vha3/Monarch-Board/Images/IMG_7050.JPG

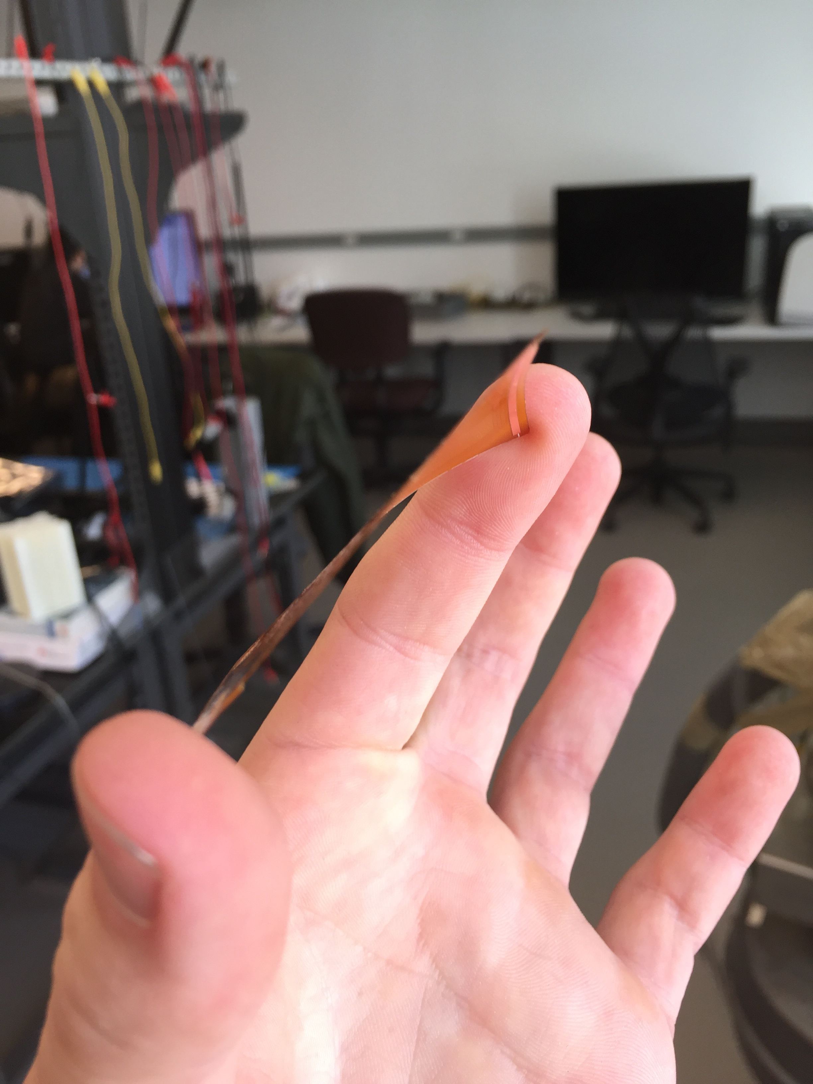
Images/IMG_7050.JPG
