vha3/Monarch-Board/Images/IMG_7051.JPG

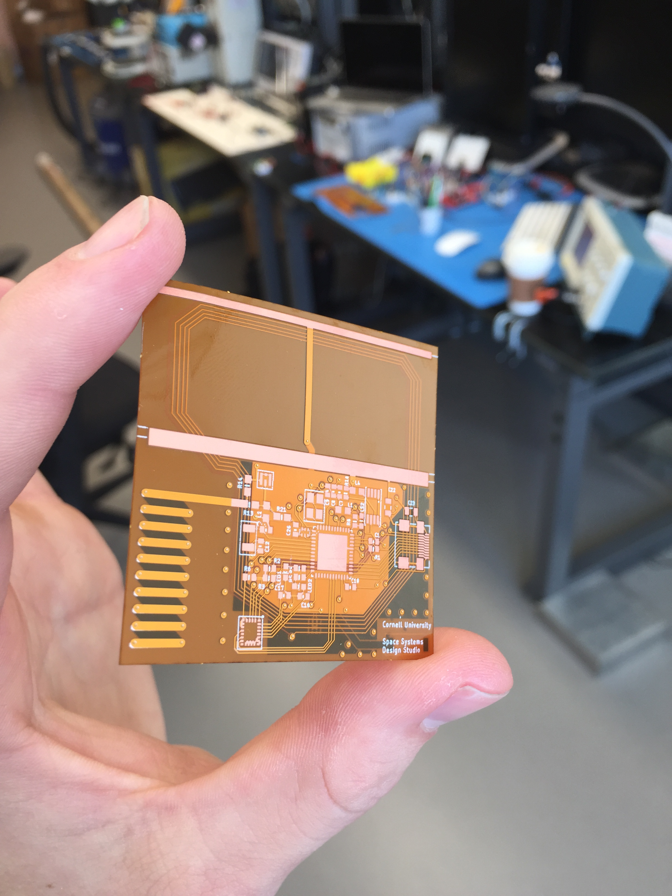
Images/IMG_7051.JPG
