vha3/Monarch-Board/BOM/BOM.xlsx

BOM:
Assembly P/N:
Customer Name: V. Hunter Adams (Cornell University)
Qty | Value | Do Not Install | Device | Package | Parts | Description | Vendor | Vendor P/N | Manufacturer P/N | Manufacturer | URL
11 | 0.1 uF |  | CAP0402-CAP | 0402-CAP | C1, C2, C3, C4, C5, C7, C9, C14, C15, C17, C18 | Capacitor | Digikey | 311-1676-2-ND | CC0402JRX7R7BB104 | Yageo | https://www.digikey.com/product-detail/en/yageo/CC0402JRX7R7BB104/311-1676-2-ND/5195085
1 | 1 uF |  | CAP0402-CAP | 0402-CAP | C10 | Capacitor | Digikey | 445-9082-2-ND | C1005X6S1C105M050BC | TDK Corporation | https://www.digikey.com/product-detail/en/tdk-corporation/C1005X6S1C105M050BC/445-9082-2-ND/3661566
1 | 10 nF |  | CAP0402-CAP | 0402-CAP | C16 | Capacitor | Digikey | 478-3664-2-ND | 0402YC103JAT2A | AVX Corporation | https://www.digikey.com/product-detail/en/avx-corporation/0402YC103JAT2A/478-3664-2-ND/1116188
1 | 10 uF |  | CAP0402-CAP | 0402-CAP | C13 | Capacitor | Digikey | 490-10693-2-ND | GRM155R60G106ME44D | Murata | https://www.digikey.com/product-detail/en/murata-electronics-north-america/GRM155R60G106ME44D/490-10693-2-ND/4905101
1 | 100 pF |  | CAP0402-CAP | 0402-CAP | C26 | Capacitor | Digikey | 478-1089-2-ND | 04025C101KAT2A | AVX Corporation | https://www.digikey.com/product-detail/en/avx-corporation/04025C101KAT2A/478-1089-2-ND/563199
1 | 100 pF |  | CAP0603-CAP | 0603-CAP | C19 | Capacitor | Digikey | 490-1427-1-ND | GRM1885C1H101JA01D | Murata | https://www.digikey.com/product-detail/en/murata-electronics-north-america/GRM1885C1H101JA01D/490-1427-1-ND/587633
1 | 100 uF |  | CAP0805 | 805 | C20 | Capacitor | Digikey | 478-8358-1-ND | F950G107MPAAQ2 | AVX Corporation | https://www.digikey.com/product-detail/en/avx-corporation/F950G107MPAAQ2/478-8358-1-ND/4005658
1 | 100k |  | RESISTOR0402-RES | 0402-RES | R1 | Resistor | Digikey | P100KDCTR-ND | ERA-2AEB104X | Panasonic | https://www.digikey.com/product-detail/en/panasonic-electronic-components/ERA-2AEB104X/P100KDCTR-ND/1706053
5 | 10k |  | RESISTOR0402-RES | 0402-RES | R6, R7, R8, R9, R12 | Resistor | Digikey | P10KDECT-ND | ERA-2AED103X | Panasonic | https://www.digikey.com/product-detail/en/panasonic-electronic-components/ERA-2AED103X/P10KDECT-ND/1706304
2 | 12 pF |  | CAP0402-CAP | 0402-CAP | C11, C12 | Capacitor | Digikey | 490-5924-2-ND | GRM1555C1H120JA01D | Murata | https://www.digikey.com/product-detail/en/murata-electronics-north-america/GRM1555C1H120JA01D/490-5924-2-ND/3693831
3 | 180 |  | RESISTOR0402-RES | 0402-RES | R4, R5, R10 | Resistor | Digikey | P180DCCT-ND | ERA-2AEB181X | Panasonic | https://www.digikey.com/product-detail/en/panasonic-electronic-components/ERA-2AEB181X/P180DCCT-ND/1706165
1 | 1k |  | RESISTOR0402-RES | 0402-RES | R11 | Resistor | Digikey | P1.0KDECT-ND | ERA-2AED102X | Panasonic | https://www.digikey.com/product-detail/en/panasonic-electronic-components/ERA-2AED102X/P1.0KDECT-ND/1706280
2 | 22 uF |  | CAP0402-CAP | 0402-CAP | C6, C8 | Capacitor | Digikey | 1276-6834-2-ND | CL05A226MQ5QUNC | Samsung | https://www.digikey.com/product-detail/en/samsung-electro-mechanics/CL05A226MQ5QUNC/1276-6834-2-ND/5961318
3 | 3.3k |  | RESISTOR0402-RES | 0402-RES | R2, R3, R19 | Resistor | Digikey | P3.3KDCCT-ND | ERA-2AEB332X | Panasonic | https://www.digikey.com/product-detail/en/panasonic-electronic-components/ERA-2AEB332X/P3.3KDCCT-ND/1706195
1 | 330 |  | RESISTOR0402-RES | 0402-RES | R20 | Resistor | Digikey | P330DECT-ND | ERA-2AED331X | Panasonic | https://www.digikey.com/product-detail/en/panasonic-electronic-components/ERA-2AED331X/P330DECT-ND/1706268
2 | 47 uF |  | CAP0805 | 805 | C22, C23 | Capacitor | Digikey | 490-6469-2-ND | GRM21BR60G476ME15L | Murata | https://www.digikey.com/product-detail/en/murata-electronics-north-america/GRM21BR60G476ME15L/490-6469-2-ND/2546873
1 | 10uH |  | ASPI-0315FS | ASPI-0315FS | L4 | Inductor | Digikey | 535-10735-2-ND | ASPI-0315FS-100M-T2 | Abracon LLC | https://www.digikey.in/product-detail/en/abracon-llc/ASPI-0315FS-100M-T2/535-10735-2-ND/2619300
1 | 2.2nH |  | INDUCTOR0603 | 603 | L3 | Inductor | Digikey | 712-1427-1-ND | L-14C2N2SV4T | Johanson Technology | https://www.digikey.com/scripts/DkSearch/dksus.dll?Detail&itemSeq=251947178&uq=636552498736187867
1 | 6.8 uH |  | INDUCTOR0603 | 603 | L1 | Inductor | Digikey | 445-1023-2-ND | MLF1608E6R8KTA00 | TDK Corporation | https://www.digikey.com/product-detail/en/tdk-corporation/MLF1608E6R8KTA00/445-1023-2-ND/504192
2 | GREEN |  | LED0603 | LED-0603 | LED3,LED2 | LED | Digikey | 475-2709-1-ND | LG L29K-G2J1-24-Z | OSRAM Opto | https://www.digikey.com/products/en?keywords=475-2709-1-ND
1 | CC1310 |  | CC1310 | CC1310 | MICROCONTROLLER | CC1310 RGZ48 package | Digikey | 296-44348-1-ND | CC1310F128RGZR | Texas Instruments | https://www.digikey.com/product-detail/en/texas-instruments/CC1310F128RGZR/296-44348-1-ND/6110621
1 | FC-135 |  | FC-135 | FC-135 | 32.768 | FC-135 32.768KA-AG0 | Digikey | SER4084CT-ND | FC-135 32.7680KA-AC0 | Epson | https://www.digikey.com/product-detail/en/epson/FC-135-32.7680KA-AC0/SER4084CT-ND/6132704
1 | HDMID |  | HDMID | HDMID | U$1 | HDMI-D Female | Digikey | WM11254CT-ND | 467650301 | Molex | https://www.digikey.com/product-detail/en/molex-llc/0467650301/WM11254CT-ND/5287246
1 | JOHANSON_BALUN |  | JOHANSON_BALUN | JOHANSON_BALUN | BALUN | 915 MHz Balun | Digikey | 712-1621-1-ND | 0850BM14E0016T | Johanson Technology | https://www.digikey.com/product-detail/en/johanson-technology-inc/0850BM14E0016T/712-1621-1-ND/6187665
1 | JOHANSON_GPS_CHIP |  | JOHANSON_GPS_CHIP | JOHANSON_GPS_CHIP | U$5 | GPS Chip Antenna | Digikey | 712-1003-1-ND | 1575AT43A0040E | Johanson Technology | https://www.digikey.com/product-detail/en/johanson-technology-inc/1575AT43A0040E/712-1003-1-ND/1560832
1 | L6920 |  | L6920 | L6920 | U$8 | Boost Converter | Digikey | 497-3368-1-ND | L6920DTR | STMicroelectronics | https://www.digikey.com/product-detail/en/stmicroelectronics/L6920DTR/497-3368-1-ND/668269
2 | LIGHTSENSORALS |  | LIGHTSENSORALS | ALS-PT19 | LS1, LS2 | Ambient Light Sensor | Digikey | 1080-1244-1-ND | ALS-PT19-315C/L177/TR8 | Everlight Electronics | https://www.digikey.com/products/en?keywords=1080-1244-1-ND
1 | LSM9DS1 |  | LSM9DS1 | LGA24-8X4 | IMU | LSM9DS1 3D accelerometer, gyroscope & magnetometer | Digikey | 497-14946-1-ND | LSM9DS1TR | STMicroelectronics | https://www.digikey.com/products/en?keywords=497-14946-1-ND
1 | LV8417CS |  | LV8417CS | LV8417CS | U$2 | H-Bridge motor driver | Digikey | LV8417CS-TE-L-HOSCT-ND | LV8417CS-TE-L-H | ON Semiconductor | https://www.digikey.com/products/en?keywords=LV8417CS-TE-L-HOSCT-ND
1 | PANASONIC_RECTIFIER |  | PANASONIC_RECTIFIER | PANASONIC_RECTIFIER | U$4 | Full bridge rectifier | Digikey | DA4X106U0RCT-ND | DA4X106U0R | Panasonic | https://www.digikey.com/product-detail/en/panasonic-electronic-components/DA4X106U0R/DA4X106U0RCT-ND/2673416
1 | RED |  | LED0603 | LED-0603 | LED1 | LED | Digikey | 475-2506-1-ND | LS L29K-G1J2-1-Z | OSRAM Opto | https://www.digikey.com/product-detail/en/osram-opto-semiconductors-inc/LS-L29K-G1J2-1-Z/475-2506-1-ND/1802633
1 | TSX-3225 |  | TSX-3225 | TSX-3225 | TSX-3225 | 24 MHz Oscillator | Digikey | SER4185CT-ND | TSX-3225 24.0000MF20G-AC0 | Epson | https://www.digikey.com/product-detail/en/epson/TSX-3225-24.0000MF20G-AC0/SER4185CT-ND/6614145
1 | VENUS838FLPX |  | VENUS838FLPX | VENUS838FLPX | GPS | Venus838FLPx-L | I will mail these to you | I will mail these to you | I will mail these to you | I will mail these to you | I will mail these to you
2 | ALTA_CELL | DNI | ALTA_CELL | ALTA_CELL | FRONT_PANEL, REAR_PANEL | Solar Cells |  | N/A | N/A | N/A | N/A
