vha3/Monarch-Board/CPL/CPL.xlsx

Top
Name | X-Coord | Y-Coord | Rotation | Value | Package
32.768 | 16.41 | 16.05 | 90 | FC-135 | FC-135
BALUN | 25.37 | 17.48 | 90 | JOHANSON_BALUN | JOHANSON_BALUN
C1 | 37.79 | 17.14 | 0 | 100nF | 0402-CAP
C7 | 31.13 | 23.81 | 90 | 100nF | 0402-CAP
C8 | 30.04 | 23.8 | 90 | 22uF | 0402-CAP
C9 | 28.97 | 23.8 | 270 | 100nF | 0402-CAP
C10 | 33.68 | 10.29 | 0 | 1uF | 0402-CAP
C11 | 19.05 | 17.32 | 0 | 12pF | 0402-CAP
C12 | 18.31 | 15.1 | 270 | 12pF | 0402-CAP
C16 | 25.56 | 8.71 | 180 | 10nF | 0402-CAP
C17 | 22.42 | 8.74 | 0 | 0.1uF | 0402-CAP
C19 | 15.85 | 23.03 | 270 | 100pF | 0603-CAP
C22 | 40.41 | 22.51 | 270 | 47uF | 805
C23 | 44.83 | 22.94 | 270 | 47uF | 805
C26 | 23.79 | 17.74 | 270 | 100pF | 0402-CAP
IMU | 17.4 | 3.83 | 270 | LSM9DS1 | LGA24-8X4
L1 | 31.86 | 21.19 | 180 | 6.8uH | 603
L4 | 33.77 | 24.42 | 180 | 10uH | ASPI-0315FS
LED1 | 22.48 | 11.86 | 180 | RED | LED-0603
LED2 | 24.74 | 9.99 | 270 | GREEN | LED-0603
LS2 | 35.12 | 19.94 | 270 | LIGHTSENSORALS | ALS-PT19
MICROCONTROLLER | 30.26 | 15.01 | 0 | CC1310 | CC1310
R1 | 37.81 | 16.04 | 180 | 100k | 0402-RES
R2 | 19.9 | 12.21 | 180 | 3.3k | 0402-RES
R3 | 19.89 | 10.91 | 180 | 3.3k | 0402-RES
R4 | 24.75 | 12.48 | 0 | 180 | 0402-RES
R5 | 24.78 | 11.27 | 0 | 180 | 0402-RES
R6 | 16.82 | 10.9 | 180 | 10k | 0402-RES
R8 | 33.98 | 19.94 | 90 | 10k | 0402-RES
REAR_PANEL | 24.96 | 39.06 | 180 | ALTA_CELL | ALTA_CELL
TSX3225 | 26.67 | 20.78 | 0 | TSX-3225 | TSX-3225
U$6 | 14.1 | 20.5 | 270 | PCB_ANTENNA | PCB_ANTENNA
U$8 | 37.46 | 22.31 | 180 | L6920 | L6920
U$9 | 45.87 | 17.05 | 90 | HDMID | HDMID
Bottom
C2 | 36.67 | 11.72 | 180 | 100nF | 0402-CAP
C3 | 36.68 | 10.64 | 180 | 100nF | 0402-CAP
C4 | 36.69 | 9.56 | 180 | 100nF | 0402-CAP
C5 | 36.69 | 8.49 | 180 | 100nF | 0402-CAP
C6 | 33.64 | 11.73 | 0 | 22uF | 0402-CAP
C13 | 33.63 | 10.64 | 0 | 10uF | 0402-CAP
C14 | 33.62 | 9.57 | 0 | 0.1uF | 0402-CAP
C15 | 33.61 | 8.49 | 0 | 0.1uF | 0402-CAP
C18 | 22.19 | 23.35 | 180 | 0.1uF | 0402-CAP
C20 | 37.68 | 18.69 | 270 | 100uF | 805
FRONT_PANEL | 24.96 | 39.05 | 180 | ALTA_CELL | ALTA_CELL
GPS | 25.72 | 14.89 | 270 | VENUS838FLPX | VENUS838FLPX
L3 | 31.66 | 4.99 | 180 | 2.2nH | 603
LED3 | 26.49 | 25.22 | 90 | BLUE | LED-0603
LS1 | 33.82 | 14.54 | 90 | LIGHTSENSORALS | ALS-PT19
R7 | 32.47 | 14.66 | 270 | 10k | 0402-RES
R9 | 19.4 | 16.65 | 270 | 10k | 0402-RES
R10 | 26.6 | 22.8 | 180 | 180 | 0402-RES
R11 | 29.7 | 22.79 | 180 | 1k | 0402-RES
R12 | 22.19 | 22.22 | 0 | 10k | 0402-RES
R19 | 33.93 | 19.64 | 180 | 3.3k | 0402-RES
R20 | 34.82 | 23.84 | 90 | 331 | 0402-RES
U$2 | 32.77 | 23.11 | 0 | LV8417CS | LV8417CS
U$4 | 37.66 | 23.46 | 0 | PANASONIC_RECTIFIER | PANASONIC_RECTIFIER
U$5 | 44.98 | 2.24 | 0 | JOHANSON_GPS_CHIP | JOHANSON_GPS_CHIP
