vha3/Monarch-Board/Eagle/Sprite_CC1310_Development.brd

## EAGLE design Eagle/Sprite_CC1310_Development.brd (2018-06-07)

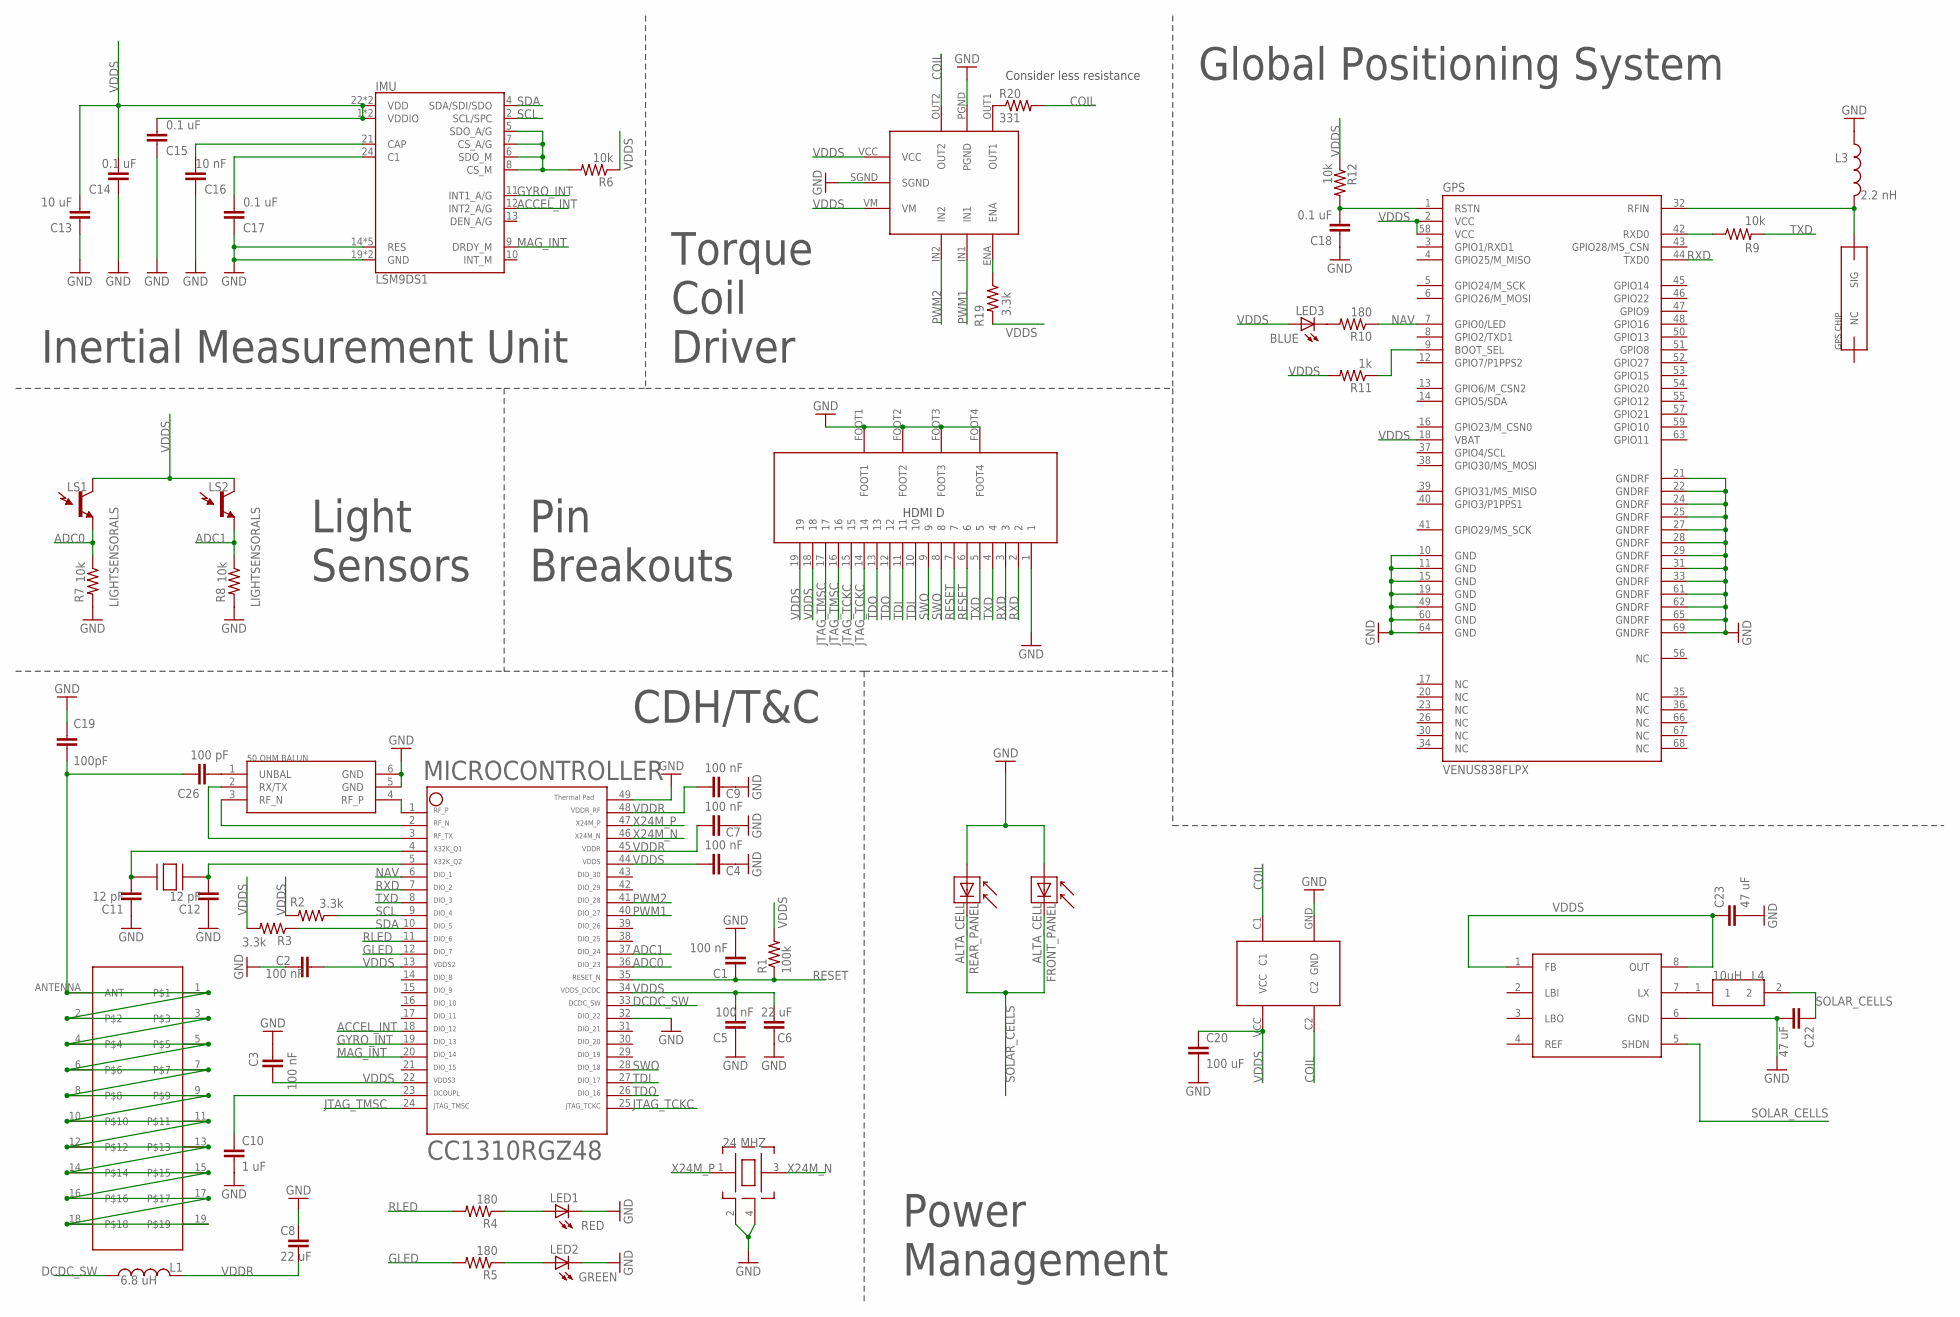
[picture p3: schematic Sprite_CC1310_Development.sch]

Parts:
32.768: FC-135
BALUN: JOHANSON_BALUN
C1, C2, C3, C4, C5, C7, C9: 100 nF; 0402-CAP
C6, C8: 22 uF; 0402-CAP
C10: 1 uF; 0402-CAP
C11, C12: 12 pF; 0402-CAP
C13: 10 uF; 0402-CAP
C14, C15, C17, C18: 0.1 uF; 0402-CAP
C16: 10 nF; 0402-CAP
C19: 100pF; 0603-CAP
C20: 100 uF; 0805
C22, C23: 47 uF; 0805
C26: 100 pF; 0402-CAP
FRONT_PANEL: ALTA_CELL
GPS: VENUS838FLPX
IMU: LSM9DS1; LGA24-8X4
L1: 6.8 uH; 0603
L3: 2.2 nH; 0603
L4: 10uH; ASPI-0315FS
LED1: RED; LED-0603
LED2: GREEN; LED-0603
LED3: BLUE; LED-0603
LS1, LS2: LIGHTSENSORALS; ALS-PT19
MICROCONTROLLER: CC1310
R1: 100k; 0402-RES
R2, R3, R19: 3.3k; 0402-RES
R4, R5, R10: 180; 0402-RES
R6, R7, R8, R9, R12: 10k; 0402-RES
R11: 1k; 0402-RES
R20: 331; 0402-RES
REAR_PANEL: ALTA_CELL
TSX3225: TSX-3225
U$2: LV8417CS
U$4: PANASONIC_RECTIFIER
U$5: JOHANSON_GPS_CHIP
U$6: PCB_ANTENNA
U$8: L6920
U$9: HDMID

Connections:
ACCEL_INT: IMU.12 (INT2_A/G), MICROCONTROLLER.18
ADC0: LS1.E (E1), MICROCONTROLLER.36, R7.1
ADC1: LS2.E (E1), MICROCONTROLLER.37, R8.1
ANTENNA: C19.2, C26.1, U$6.1, U$6.2, U$6.3, U$6.4, U$6.5, U$6.6, U$6.7, U$6.8, U$6.9, U$6.10, U$6.11, U$6.12, U$6.13, U$6.14, U$6.15, U$6.16, U$6.17, U$6.18, U$6.19, U$6.ANTENNA (ANT)
COIL: R20.2, U$2.OUT2, U$4.C1, U$4.C2
DCDC_SW: L1.1, MICROCONTROLLER.33
GLED: MICROCONTROLLER.12, R5.2
GND: BALUN.5 (GND), BALUN.6 (GND), C1.2, C2.2, C3.2, C4.2, C5.2, C6.2, C7.2, C8.2, C9.2, C10.2, C11.2, C12.2, C13.2, C14.2, C15.2, C16.2, C17.2, C18.2, C19.1, C20.2, C22.2, C23.2, FRONT_PANEL.-, GPS.10 (GND), GPS.11 (GND), GPS.15 (GND), GPS.19 (GND), GPS.21 (GNDRF), GPS.22 (GNDRF), GPS.24 (GNDRF), GPS.25 (GNDRF), GPS.27 (GNDRF), GPS.28 (GNDRF), GPS.29 (GNDRF), GPS.31 (GNDRF), GPS.33 (GNDRF), GPS.49 (GND), GPS.60 (GND), GPS.61 (GNDRF), GPS.62 (GNDRF), GPS.64 (GND), GPS.65 (GNDRF), GPS.69 (GNDRF), IMU.14 (RES), IMU.15 (RES), IMU.16 (RES), IMU.17 (RES), IMU.18 (RES), IMU.19 (GND), IMU.20 (GND), L3.1, LED1.C, LED2.C, MICROCONTROLLER.32, MICROCONTROLLER.49, R7.2, R8.2, REAR_PANEL.-, TSX3225.2, TSX3225.4, U$2.PGND, U$2.SGND, U$4.GND, U$8.6 (GND), U$9.1, U$9.FOOT1, U$9.FOOT2, U$9.FOOT3, U$9.FOOT4
GYRO_INT: IMU.11 (INT1_A/G), MICROCONTROLLER.19
JTAG_TCKC: MICROCONTROLLER.25, U$9.14, U$9.15
JTAG_TMSC: MICROCONTROLLER.24, U$9.16, U$9.17
MAG_INT: IMU.9 (DRDY_M), MICROCONTROLLER.20
unnamed: C10.1, MICROCONTROLLER.23
unnamed: 32.768.P2, C11.1, MICROCONTROLLER.4
unnamed: 32.768.P1, C12.1, MICROCONTROLLER.5
unnamed: LED1.A, R4.1
unnamed: LED2.A, R5.1
unnamed: IMU.5 (SDO_A/G), IMU.6 (SDO_M), IMU.7 (CS_A/G), IMU.8 (CS_M), R6.2
unnamed: GPS.42 (RXD0), R9.1
unnamed: C16.1, IMU.21 (CAP)
unnamed: C17.1, IMU.24 (C1)
unnamed: LED3.C, R10.2
unnamed: GPS.9 (BOOT_SEL), R11.1
unnamed: C18.1, GPS.1 (RSTN), R12.2
unnamed: GPS.32 (RFIN), L3.2, U$5.SIG
unnamed: R19.1, U$2.ENA
unnamed: R20.1, U$2.OUT1
unnamed: BALUN.1 (UNBAL), C26.2
unnamed: BALUN.4 (RF_P), MICROCONTROLLER.1
unnamed: BALUN.3 (RF_N), MICROCONTROLLER.2
unnamed: BALUN.2 (RX/TX), MICROCONTROLLER.3
unnamed: L4.1, U$8.7 (LX)
NAV: GPS.7 (GPIO0/LED), MICROCONTROLLER.6, R10.1
PWM1: MICROCONTROLLER.40, U$2.IN1
PWM2: MICROCONTROLLER.41, U$2.IN2
RESET: C1.1, MICROCONTROLLER.35, R1.1, U$9.6, U$9.7
RLED: MICROCONTROLLER.11, R4.2
RXD: GPS.44 (TXD0), MICROCONTROLLER.7, U$9.2, U$9.3
SCL: IMU.2 (SCL/SPC), MICROCONTROLLER.9, R2.1
SDA: IMU.4 (SDA/SDI/SDO), MICROCONTROLLER.10, R3.1
SOLAR_CELLS: C22.1, FRONT_PANEL.+, L4.2, REAR_PANEL.+, U$8.5 (SHDN)
SWO: MICROCONTROLLER.28, U$9.8, U$9.9
TDI: MICROCONTROLLER.27, U$9.10, U$9.11
TDO: MICROCONTROLLER.26, U$9.12, U$9.13
TXD: MICROCONTROLLER.8, R9.2, U$9.4, U$9.5
VDDR: C7.1, C8.1, C9.1, L1.2, MICROCONTROLLER.45, MICROCONTROLLER.48
VDDS: C2.1, C3.1, C4.1, C5.1, C6.1, C13.1, C14.1, C15.1, C20.1, C23.1, GPS.2 (VCC), GPS.18 (VBAT), GPS.58 (VCC), IMU.1 (VDDIO), IMU.3 (VDDIO), IMU.22 (VDD), IMU.23 (VDD), LED3.A, LS1.C (C1), LS2.C (C1), MICROCONTROLLER.13, MICROCONTROLLER.22, MICROCONTROLLER.34, MICROCONTROLLER.44, R1.2, R2.2, R3.2, R6.1, R11.2, R12.1, R19.2, U$2.VCC, U$2.VM, U$4.VCC, U$8.1 (FB), U$8.8 (OUT), U$9.18, U$9.19
X24M_N: MICROCONTROLLER.46, TSX3225.3
X24M_P: MICROCONTROLLER.47, TSX3225.1

Notes on the sheet:
CDH/T&C
Inertial Measurement Unit
Power Management
Light Sensors
Global Positioning System
Pin Breakouts
Torque Coil Driver
Consider less resistance

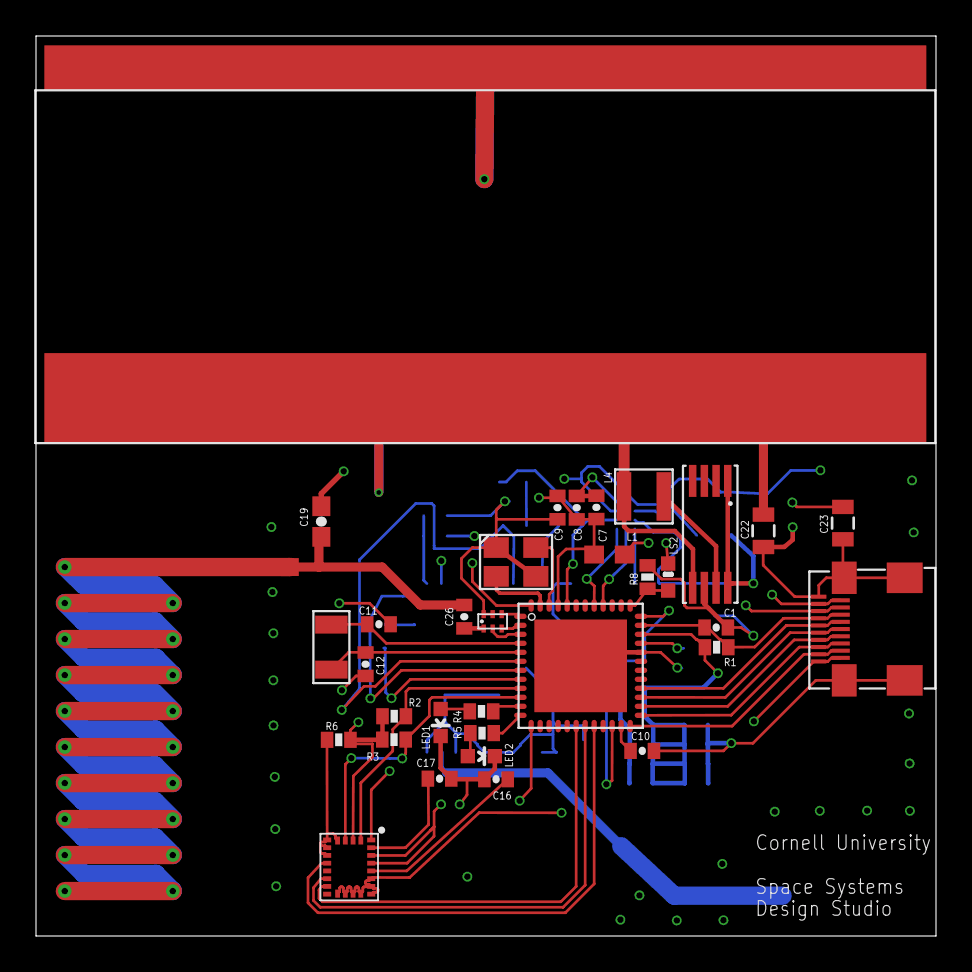
[picture p4: board Sprite_CC1310_Development.brd from above]

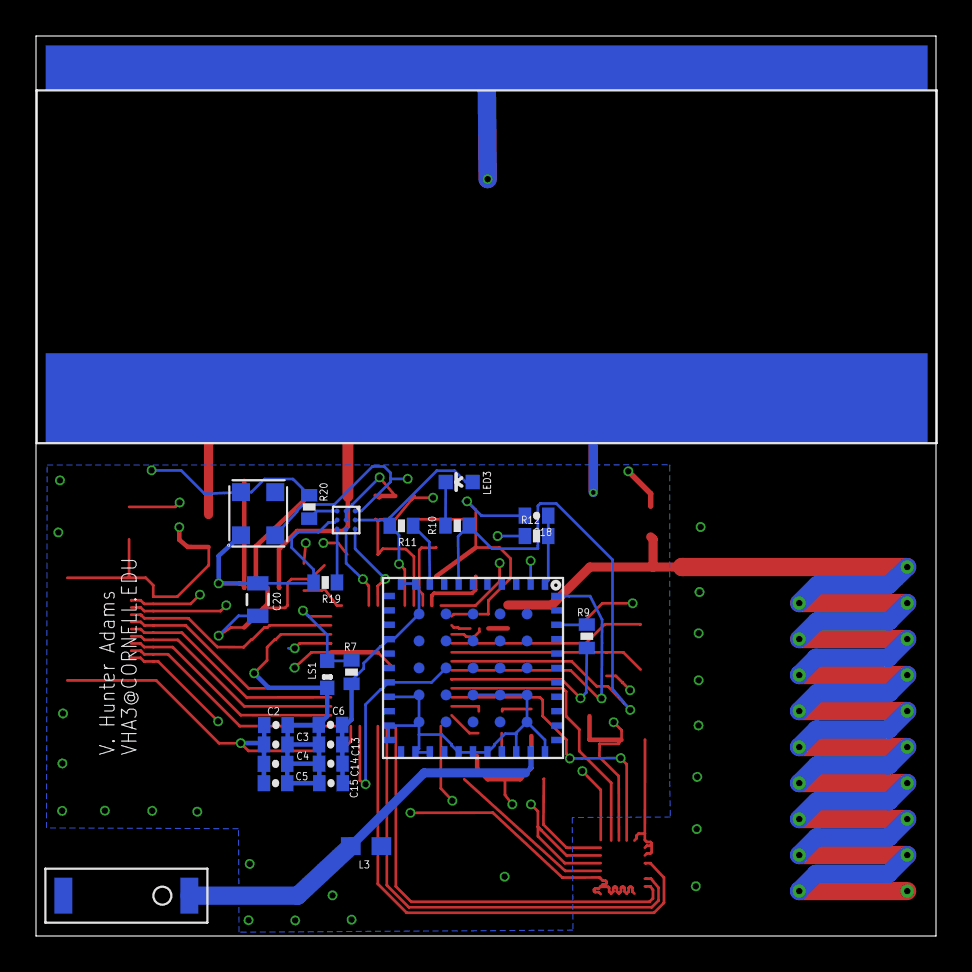
[picture p5: board Sprite_CC1310_Development.brd from below]

Board: 4 copper layers, 50.0 x 50.0 mm, 59 parts (26 on the bottom side), 49 nets.
