vha3/Monarch-Board/(commit log)

2018-01-19 routing in progress
    [Sprite_CC1310_Development.brd]
2018-01-19 still working
    [Sprite_CC1310_Development.brd, Sprite_CC1310_Development.sch]
2018-01-21 still routing
    [Sprite_CC1310_Development.brd, Sprite_CC1310_Development.sch]
2018-01-22 fixed antenna
    [Sprite_CC1310_Development.brd, Sprite_CC1310_Development.sch]
2018-01-22 draft layout complete
    [Sprite_CC1310_Development.brd, Sprite_CC1310_Development.sch]
2018-01-23 added silkscreen
    [Sprite_CC1310_Development.brd, Sprite_CC1310_Development.sch]
2018-01-24 need new boost converter, obsolete component :(
    [BOM.csv, Sprite_CC1310_Development.brd, Sprite_CC1310_Development.sch, Working_BOM.xlsx]
2018-01-24 updated boost regulator
    [Sprite_CC1310_Development.brd, Sprite_CC1310_Development.sch]
2018-01-25 cleaning up
    [Sprite_CC1310_Development.brd, Sprite_CC1310_Development.sch]
2018-02-25 Updated matching network
    [BOM.xlsx, Sprite_CC1310_Development.brd, Sprite_CC1310_Development.sch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]
2018-02-27 rearranging files
    [BOM.xlsx, Sprite_CC1310_Development.brd, Sprite_CC1310_Development.sch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]
2018-03-08 updated BOM
    [BOM.xlsx]
2018-03-12 Fixed HDMI
    [BOM.xlsx, Sprite_CC1310_Development.brd, Sprite_CC1310_Development.sch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]
2018-04-12 fixed BOM
    [BOM.xlsx]
2018-06-07 updated boost converter, eliminated unnecessary tuning components, rotated oscillator, updated solar pads
    [BOM.xlsx, Sprite_CC1310_Development.brd, Sprite_CC1310_Development.sch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]
